arthurnbr/ezCore/hardware/fab/render_3d_bottom.png

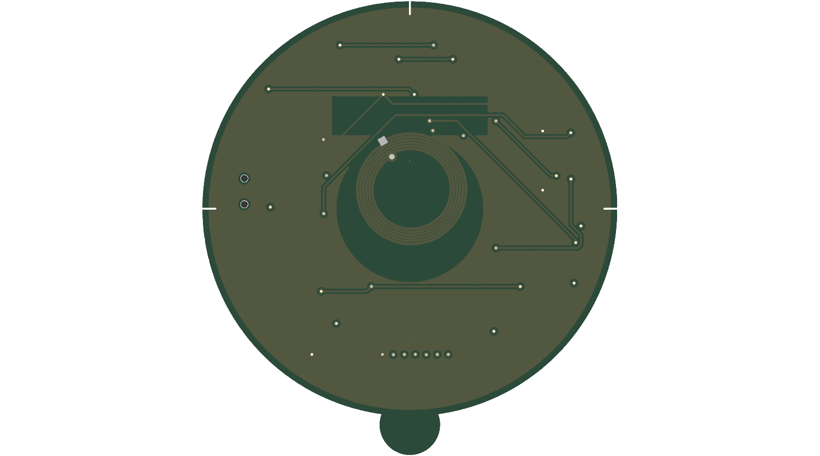
hardware/fab/render_3d_bottom.png
