arthurnbr/ezCore/hardware/fab/render_3d_top.png

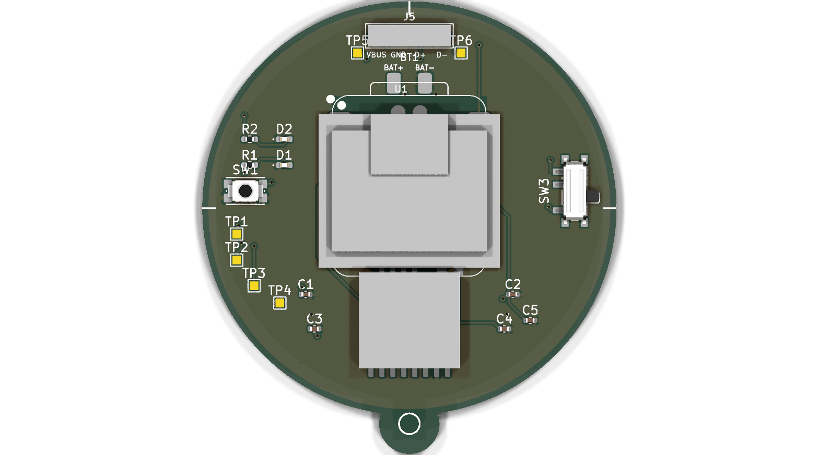
hardware/fab/render_3d_top.png
