arthurnbr/ezCore/hardware/fab/schematic.png

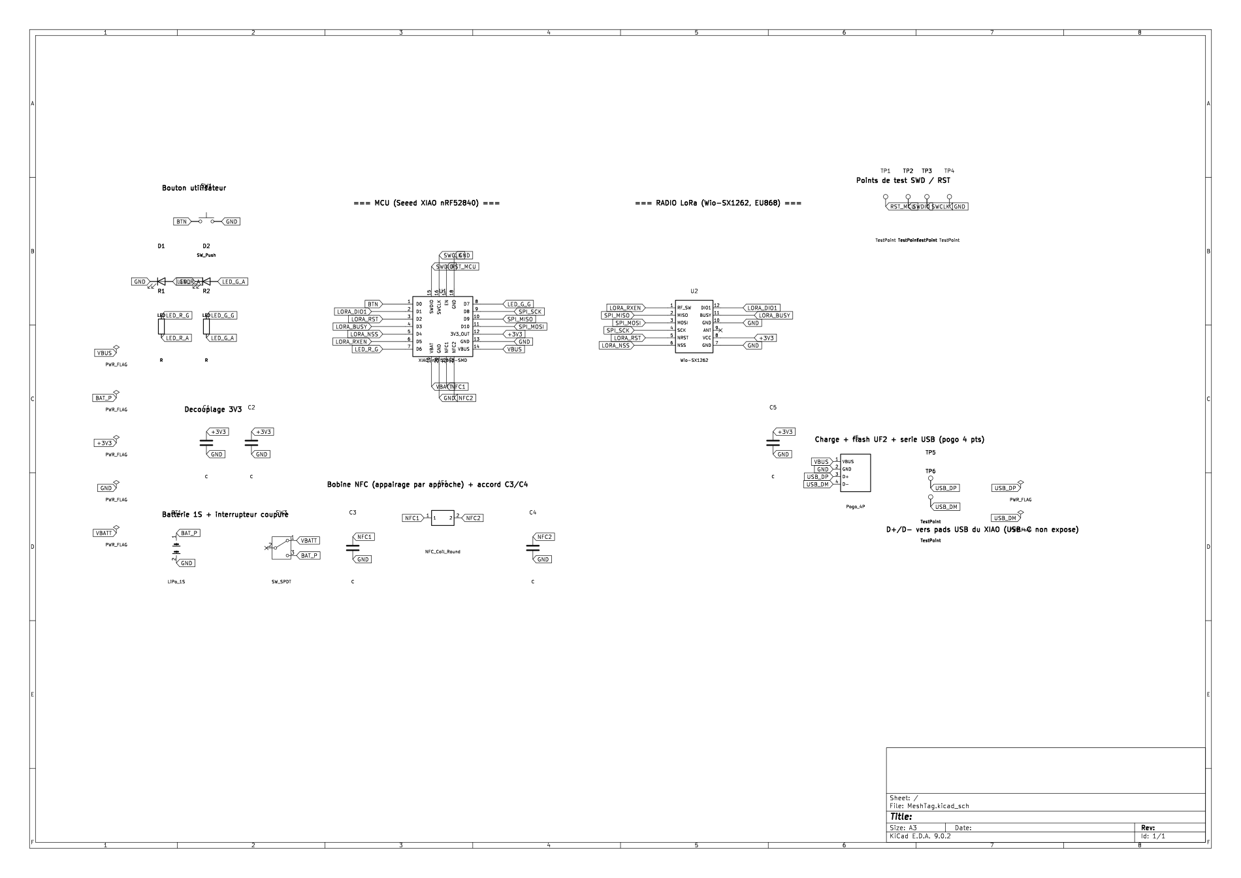
hardware/fab/schematic.png
