arthurnbr/ezCore/hardware/fab/BOM.csv

Reference | Value | Footprint | Qty | LCSC | MPN | Manufacturer | JLC
AE1 | NFC_Coil_Round | MeshTag:NFC_Coil_Round | 1
BT1 | LiPo_1S | MeshTag:Batt_WirePads_2x | 1
C1 | 10uF 6.3V X5R | MeshTag:C_0402_1005Metric | 1 | C15525 | CL05A106MQ5NUNC | Samsung Electro-Mechanics
C2,C5 | 100nF 16V X7R | MeshTag:C_0402_1005Metric | 2 | C1525 | CL05B104KO5NNNC | Samsung Electro-Mechanics
C3,C4 | 47pF 50V C0G | MeshTag:C_0402_1005Metric | 2 | C1567 | 0402CG470J500NT | FH (Guangdong Fenghua)
D1 | XL-1005SURC (rouge) | MeshTag:LED_0402_Red_XL-1005SURC | 1 | C25503345 | XL-1005SURC | XINGLIGHT
D2 | XL-1005UGC (vert) | MeshTag:LED_0402_Green_XL-1005UGC | 1 | C965793 | XL-1005UGC | XINGLIGHT
J5 | YZT0675-20048-04025-01 | MeshTag:MagPogo_4P_P2.50mm_YZT0675 | 1 | C5126846 | YZT0675-20048-04025-01 | Xinyangze
R1,R2 | 470R 1% | MeshTag:R_0402 | 2 | C25117 | 0402WGF4700TCE | UNI-ROYAL
SW1 | KMR221GLFS | MeshTag:SW_Push_1P1T-SH_NO_CK_KMR2xxG | 1 | C72443 | KMR221GLFS | C&K
SW3 | PCM12SMTR | MeshTag:SW_SPDT_PCM12 | 1 | C221841 | PCM12SMTR | C&K
TP1-TP6 | TestPoint | MeshTag:TestPoint_Pad_1.0x1.0mm | 6
U1 | XIAO-nRF52840-SMD | MeshTag:XIAO-nRF52840-SMD | 1 |  | 102010448 | Seeed Studio | Non assemblé par JLC - soudé à la main
U2 | Wio-SX1262 | MeshTag:Wio-SX1262-Module | 1 |  | 114993390 | Seeed Studio | Non assemblé par JLC - soudé à la main
