arthurnbr/ezCore/hardware/fab/MeshTag_PCB_noUSBC.step

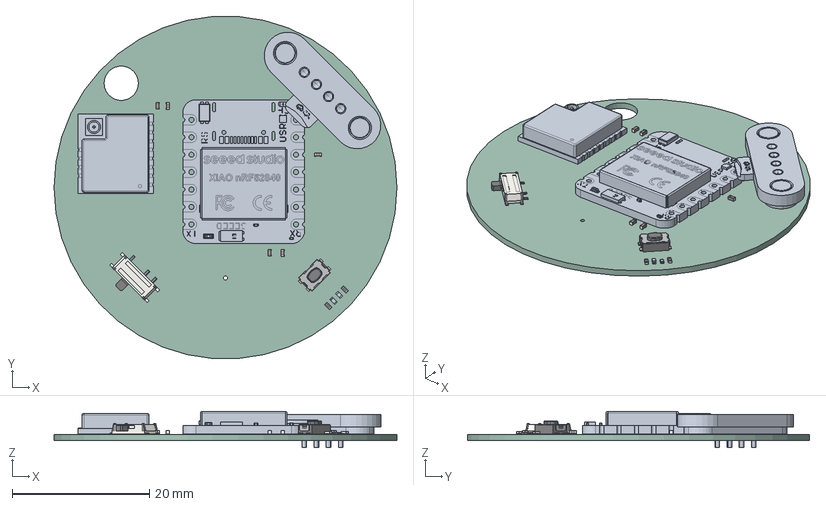
[picture p4: CAD file, 2026-11-14]
hardware/fab/MeshTag_PCB_noUSBC.step
50.0 x 49.9 x 5.27 mm
C_0402_1005Metric x 5
R_0402_1005Metric x 2
Fusion_sp
SW_Push_1P1T-SH_NO_CK_KMR2xxG
MeshTag_PCB
