arthurnbr/ezCore/hardware/MeshTag.kicad_pcb

## KiCad design hardware/MeshTag.kicad_pcb (2026-11-13)

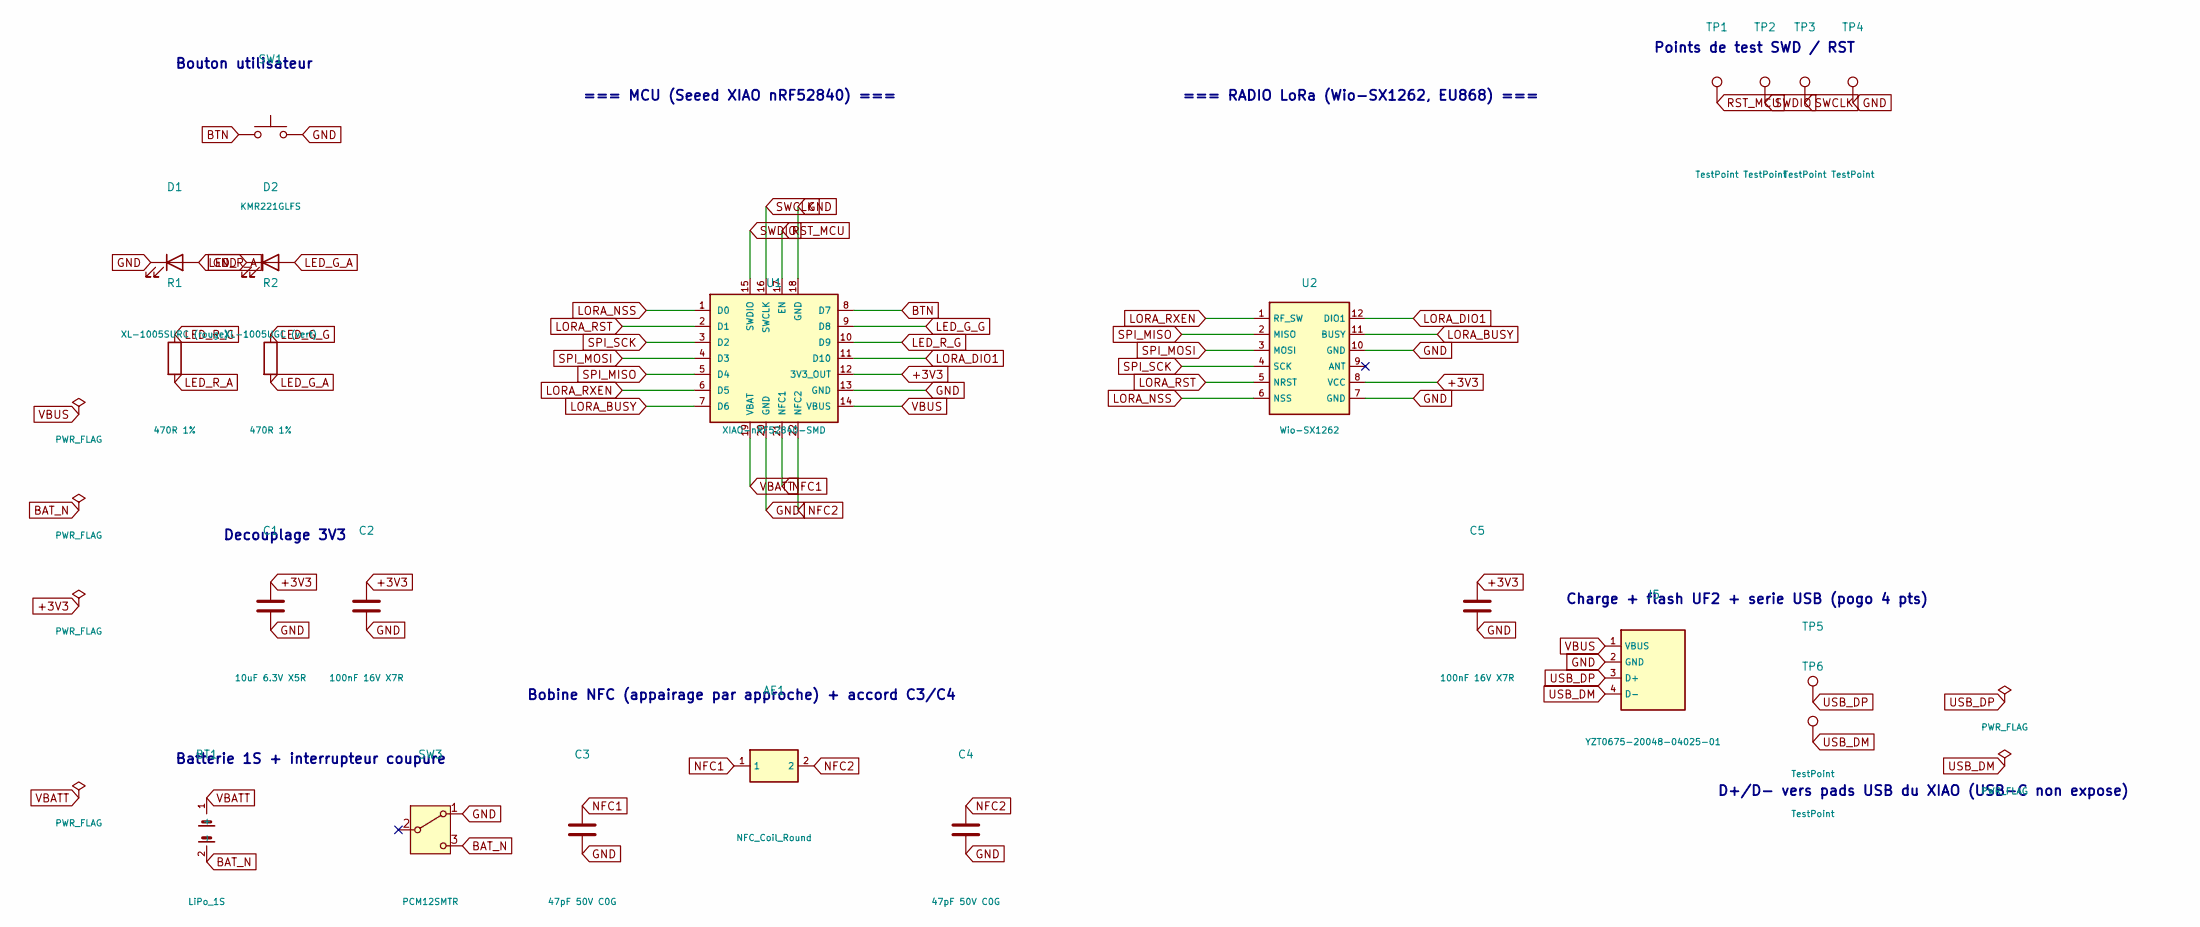
[picture p5: schematic MeshTag.kicad_sch]

Parts:
AE1: NFC_Coil_Round
BT1: LiPo_1S; Batt_WirePads_2x
C1: 10uF 6.3V X5R; C_0402_1005Metric; MPN CL05A106MQ5NUNC; LCSC C15525
C2, C5: 100nF 16V X7R; C_0402_1005Metric; MPN CL05B104KO5NNNC; LCSC C1525
C3, C4: 47pF 50V C0G; C_0402_1005Metric; MPN 0402CG470J500NT; LCSC C1567
D1: XL-1005SURC (rouge); LED_0402_Red_XL-1005SURC; MPN XL-1005SURC; LCSC C25503345
D2: XL-1005UGC (vert); LED_0402_Green_XL-1005UGC; MPN XL-1005UGC; LCSC C965793
J5: YZT0675-20048-04025-01; MagPogo_4P_P2.50mm_YZT0675; MPN YZT0675-20048-04025-01; LCSC C5126846
R1, R2: 470R 1%; R_0402; MPN 0402WGF4700TCE; LCSC C25117
SW1: KMR221GLFS; SW_Push_1P1T-SH_NO_CK_KMR2xxG; MPN KMR221GLFS; LCSC C72443
SW3: PCM12SMTR; SW_SPDT_PCM12; MPN PCM12SMTR; LCSC C221841
TP1, TP2, TP3, TP4, TP5, TP6: TestPoint; TestPoint_Pad_1.0x1.0mm
U1: XIAO-nRF52840-SMD; MPN 102010448; JLC Non assemblé par JLC - soudé à la main
U2: Wio-SX1262; Wio-SX1262-Module; MPN 114993390; JLC Non assemblé par JLC - soudé à la main

Connections:
+3V3: C1.1, C2.1, C5.1, U1.12 (3V3_OUT), U2.8 (VCC)
BAT_N: BT1.2 (-), SW3.3 (C)
BTN: SW1.1, U1.8 (D7)
GND: C1.2, C2.2, C3.2, C4.2, C5.2, D1.1 (K), D2.1 (K), J5.2 (GND), SW1.2, SW3.1 (A), TP4.1, U1.13 (GND), U1.18 (GND), U1.20 (GND), U2.7 (GND), U2.10 (GND)
LED_G_A: D2.2 (A), R2.2
LED_G_G: R2.1, U1.9 (D8)
LED_R_A: D1.2 (A), R1.2
LED_R_G: R1.1, U1.10 (D9)
LORA_BUSY: U1.7 (D6), U2.11 (BUSY)
LORA_DIO1: U1.11 (D10), U2.12 (DIO1)
LORA_NSS: U1.1 (D0), U2.6 (NSS)
LORA_RST: U1.2 (D1), U2.5 (NRST)
LORA_RXEN: U1.6 (D5), U2.1 (RF_SW)
NFC1: AE1.1, C3.1, U1.21 (NFC1)
NFC2: AE1.2, C4.1, U1.22 (NFC2)
RST_MCU: TP1.1, U1.17 (EN)
SPI_MISO: U1.5 (D4), U2.2 (MISO)
SPI_MOSI: U1.4 (D3), U2.3 (MOSI)
SPI_SCK: U1.3 (D2), U2.4 (SCK)
SWCLK: TP3.1, U1.16 (SWCLK)
SWDIO: TP2.1, U1.15 (SWDIO)
USB_DM: J5.4 (D-), TP6.1
USB_DP: J5.3 (D+), TP5.1
VBATT: BT1.1 (+), U1.19 (VBAT)
VBUS: J5.1 (VBUS), U1.14 (VBUS)

Notes on the sheet:
Decouplage 3V3
Points de test SWD / RST
Batterie 1S + interrupteur coupure
=== RADIO LoRa (Wio-SX1262, EU868) ===
D+/D- vers pads USB du XIAO (USB-C non expose)
=== MCU (Seeed XIAO nRF52840) ===
Bouton utilisateur
Bobine NFC (appairage par approche) + accord C3/C4
Charge + flash UF2 + serie USB (pogo 4 pts)

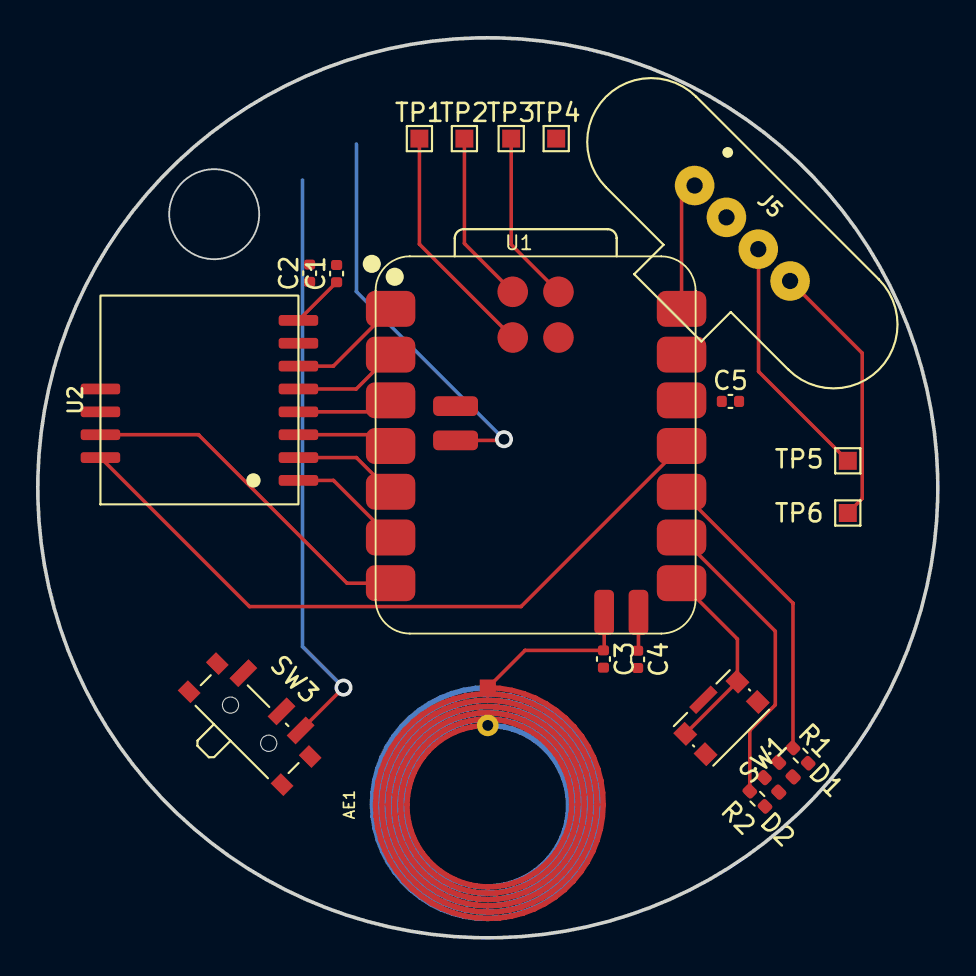
[picture p6: board MeshTag.kicad_pcb from above]

Board: 2 copper layers, 50.0 x 50.0 mm, 22 parts (1 on the bottom side), 25 nets.
