arthurnbr/ezCore/(commit log)

2026-11-13 MeshTag: PCB compagnon MeshCore (XIAO nRF52840 + Wio-SX1262) générée par script
    - Projet KiCad 9 autonome: tous symboles/empreintes/3D copiés dans lib/
    - Schéma généré, ERC 0/0
    - PCB 26x52mm 2 couches, placée + autoroutée (Freerouting), plans GND, keep-outs BLE/NFC
    - Bobine NFC net-tie intégrée (appairage par approche)
    - Scripts reproductibles tools/build_pcb.py + tools/route_pcb.sh
    - Gerbers + BOM dans fab/, sourcing dans docs/
    [BOM.csv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]
2026-11-13 fab: ajoute rendus top/bottom; parité schéma/PCB vérifiée (14 composants, 19 nets)
2026-11-13 V2 circulaire: disque Ø48, pogo 4P, batterie 1000mAh, bobine NFC ronde, antenne LoRa périphérique
    - Forme ronde Ø48 + oreille porte-clés NPTH (plus à travers la carte)
    - Wio-SX1262 en bord, IPEX vers le pourtour (FPC enroulée ~270°)
    - Pogo J5 VBUS/GND/D+/D- (charge+flash UF2+série), USB-C XIAO non exposé
    - Batterie LPR604543 ronde 1050mAh, découplage C5 100nF, 0 pull-up SPI
    - Schéma ERC 0/0, placement 0 conflit, GND coulé 2 faces, 118 tracks routés
    - ~13 nets courts à finir en GUI (doc à jour)
    - Gerbers + BOM + rendus + sourcing docs/bom_v2.md
    [BOM.csv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]
2026-11-13 V2 gravable maison: règles 0.3mm, vias 0.6mm riveteables, 3 fiducials de calage recto-verso, bobine NFC via 0.6
    - Netclass: pistes 0.3mm / isolation 0.3mm / vias pad 1.0mm perçage 0.6mm
    - Bobine NFC ronde Ø13 avec via central 0.6mm (riveteable)
    - Empreinte Fiducial_Align_1.5mm + FID1/2/3 en triangle pour calage double face
    - Doc: section Fabrication maison (photogravure UV)
    [MeshTag.kicad_pcb]
2026-11-13 Nettoyage pour atelier: schéma lisible, 3D sur chaque footprint, trou porte-clés retiré
    - Trou/oreille porte-clés RETIRÉ de la PCB (géré au boîtier) - contour cercle simple
    - 0 résistance confirmé (schéma + BOM)
    - Footprints auditées; empreinte Wio-SX1262 corrigée (pads 0.6x2.2 pitch 1.27 par datasheet)
    - Supprimé footprints/symboles inutilisés (NFC_Coil_5T_2L rect, MountingHole)
    - Modèles 3D STEP sur chaque footprint composant (XIAO/Wio/pogo/batterie générés cadquery, caps/switch KiCad); réf 3D KMR2 cassée corrigée; XIAO recentré
    - Schéma refait (tools/gen_sch.py): blocs annotés, stubs anti-chevauchement, ERC 0/0
    - docs/fp_audit.md, rendus schematic.png + render_3d_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
    [MeshTag.kicad_pcb, MeshTag.kicad_sch]
2026-11-13 Update MeshTag schematic and project settings
    [MeshTag.kicad_sch]
2026-11-13 PCB: tout sur la face avant, batterie seule au dos + ferrite
    - Tous les composants réorganisés sur la FACE AVANT (gravure simple face des pièces)
    - Bobine NFC centrée sous le XIAO (OK: FR4+MCU transparents au champ magnétique)
    - Batterie Ø45 au DOS dans le boîtier + film ferrite 0.1mm obligatoire (doc stack)
    - Modèle 3D batterie retiré (ce sont juste les pastilles BT1, pas un CMS)
    - Offsets 3D XIAO/Wio/pogo corrigés (modèles recalés sur les pads, plus éclatés)
    - Schéma NON modifié (préservé)
    - Gerbers + rendus 3D régénérés
    [MeshTag-B_Courtyard.gbr, MeshTag-B_Cu.gbl, MeshTag-B_Fab.gbr, MeshTag-B_Mask.gbs, MeshTag-B_Paste.gbp, MeshTag-B_Silkscreen.gbo, MeshTag-Edge_Cuts.gm1, MeshTag-F_Courtyard.gbr]
2026-11-13 V3 UX: LED bi-couleur, placement pensé usage, languette porte-clés, calage bord
    - LED bi-couleur rouge/vert (D1/D2) + résistances série R1/R2 sur D6/D7 (retour user type AirPods)
    - Placement UX: pogo HAUT, bouton+LED GAUCHE (90° pogo), debug SWD sous bouton, switch ON/OFF DROITE, MCU+NFC+Wio centre
    - Contour rond fermé + languette porte-clés BAS (repère perçage silk, pas de trou cuivre)
    - FID1/2/3 supprimés -> repères de calage recto-verso en traits de bord (silk N/E/O)
    - Schéma: labels tous horizontaux (correction orientation), ERC 0/0
    - Lib: footprints LED_0603 + R_0603 (avec 3D), symboles LED+R
    - Routé (181 pistes), ~16 nets courts à finir en GUI; mask_bridge castellations/c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
    [BOM.csv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]
2026-11-13 Fix: footprints assignés sur chaque symbole (mise à jour schéma->PCB) + C/R/LED en 0402
    - gen_sch.py: écrit la propriété Footprint sur CHAQUE instance (plus 'no footprint assigned')
    - Tous les condensateurs, résistances et LED passés en 0402 (petits, ressources dispo)
    - Ajout footprints R_0402 + LED_0402 (avec 3D) dans la lib locale
    - ERC 0/0, netlist contient les 22 footprints, build PCB OK
    - Routé (168 pistes); mask_bridge coil/castellations cosmétiques
    [BOM.csv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]
2026-11-13 Update MeshTag schematic, PCB and project settings
    [MeshTag.kicad_pcb, MeshTag.kicad_sch]
2026-11-13 Re-brochage U1: pads 1-7 face aux broches Wio 6,5,4,3,2,1,11, DIO1 sur pad 11, LED pads 8/9, bouton pad 10
    [MeshTag.kicad_pcb, MeshTag.kicad_sch]
2026-11-13 PCB: avancement placement et routage
    [MeshTag.kicad_pcb]
2026-11-13 U1: bouton pad 8 / LED rouge pad 10; coupure batterie côté masse (SW3 sur BAT-)
    [MeshTag.kicad_pcb, MeshTag.kicad_sch]
2026-11-13 JLC PCBA: LCSC/MPN sur chaque composant, pogo magnétique 2,5 mm (YZT0675), empreintes + STEP sourcés, BOM/CPL/gerbers JLC
    [BOM.csv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]
2026-11-13 U1/U2: retire DNP (3D visible), restent exclus BOM/CPL JLC
    [BOM.csv, MeshTag.kicad_pcb, MeshTag.kicad_sch]
2026-11-14 Enclosure: boîtier Onshape type AirTag (face avant nue, fonctions au dos), source FeatureScript + scripts de cotes + STEP PCB sans USB-C
    [MeshTag_PCB_noUSBC.step]
